Camilo1408/config-ricevi/demo_tolva/repeticion/IMG_1577_0011.jpg

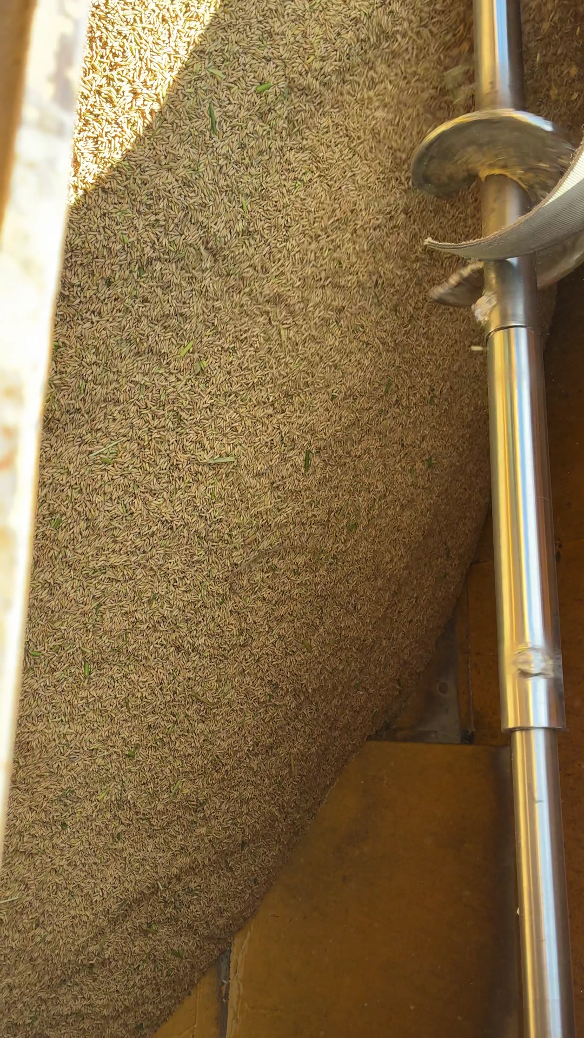
demo_tolva/repeticion/IMG_1577_0011.jpg
