Camilo1408/config-ricevi/demo_tolva/repeticion/IMG_1577_0022.jpg

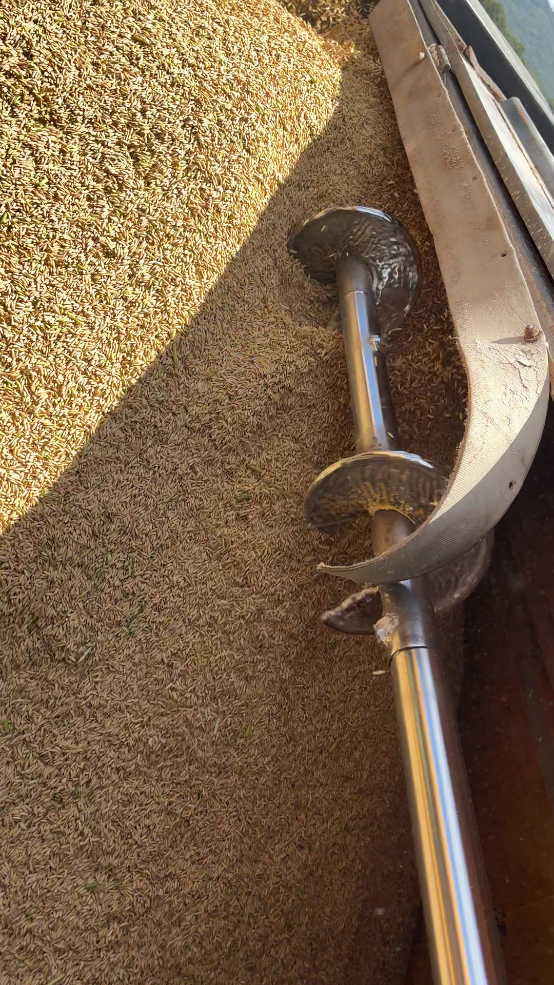
demo_tolva/repeticion/IMG_1577_0022.jpg
