Camilo1408/config-ricevi/demo_tolva/repeticion/IMG_1577_0026.jpg

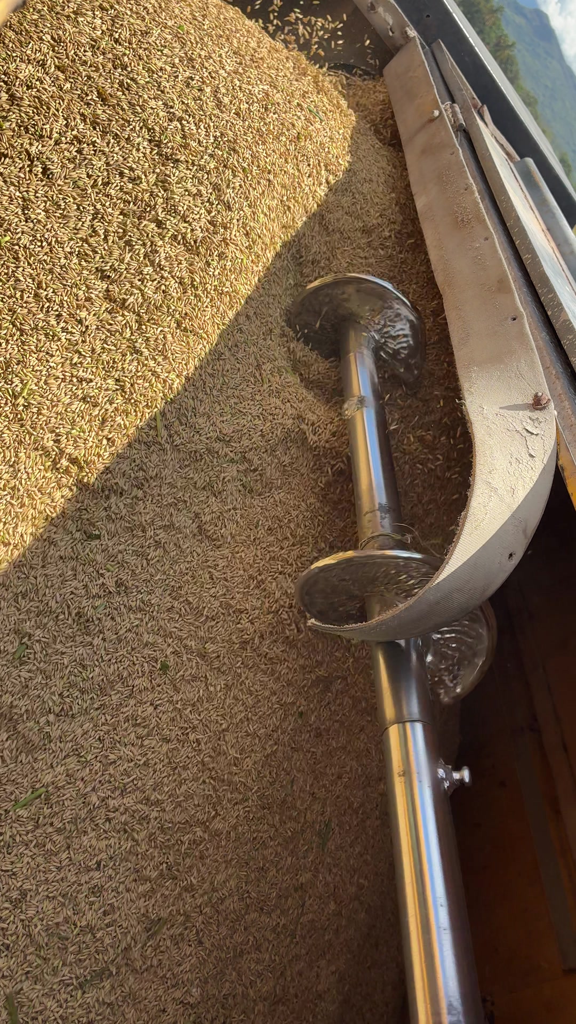
demo_tolva/repeticion/IMG_1577_0026.jpg
