Camilo1408/config-ricevi/demo_tolva/repeticion/IMG_1577_0034.jpg

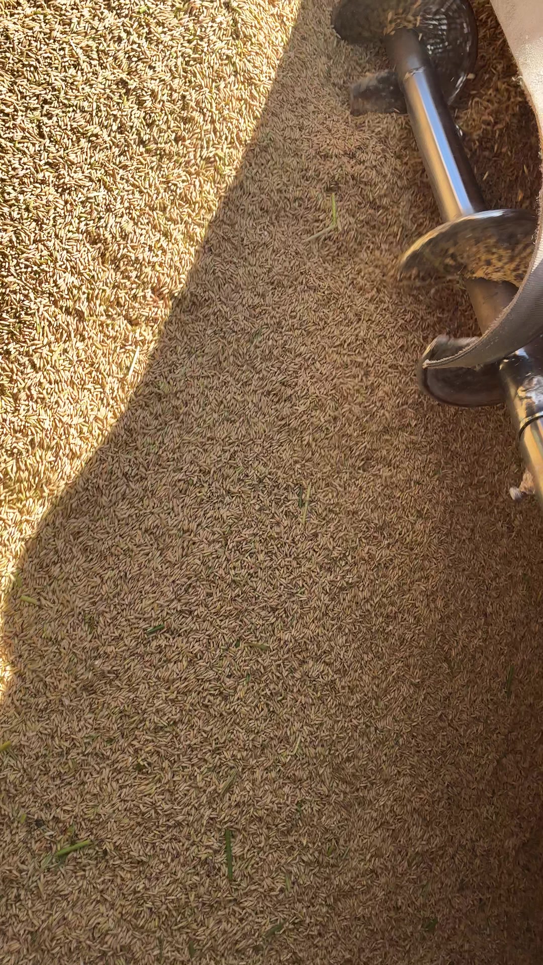
demo_tolva/repeticion/IMG_1577_0034.jpg
