Camilo1408/config-ricevi/(commit log)

2026-09-21 Sistema RiceVi en campo: configuracion, firmware, central y documentacion
    Configuracion completa para el montaje real sobre la cosechadora, en dos
    fases: captura de dataset primero, inferencia in situ despues, sobre el
    mismo codigo y sin recablear nada.
    config/ censo de los 8 nodos, calibraciones y planes. Fuente unica
    de verdad: las IP, ranuras de reloj, ROI y ritmos de captura
    salen de aqui, no del firmware.
    central/ FastAPI sobre la Raspberry Pi 5: ingesta, sincronizacion de
    reloj, turnos de subida, fusion, SQLite en WAL y HMI.
    nodos/ firmware de las 8 ESP32-S3 (4 camara, 2 Hall, 2 ultrasonico)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
2026-10-22 Hardware de octubre: nodos ESP32-C6, RCWL-1655, pilas AA y documentacion v1.2
    - Nodos de sensor en ESP32-C6 DevKitC (pines condicionales, LED en GPIO8).
    - Ultrasonico reescrito para el RCWL-1655 en modo Trig/Echo.
    - Hall: derivada sobre ventana deslizante de 1 s.
    - Nodos sin microSD; alimentacion con 4 AA Ni-MH en el censo.
    - Router Tenda N301, provision y HMI actualizados.
    - docs/01 v1.2, README y nodos/README con el hardware actual.
2026-10-22 Documentacion v1.2 completa: docs/02, docs/03, diagramas y entregables
    - docs/02 y docs/03 pasan a v1.2 (partiendo de la v1.1): compilacion para
    ESP32-C6, pilas AA Ni-MH, nodos sin microSD, LiFePO4 de cabina, Tenda N301.
    - Diagramas 01, 02 y 05 redibujados con el hardware actual.
    - docx y pdf de los tres capitulos regenerados.
    - Textos de checksum/timeout en censo y contratos acordes al RCWL-1655.
2026-10-23 Velocidad por GPS, siete nodos y documentacion v1.3 con el concurso
    La velocidad de avance pasa del Hall de rueda (NH02) a un GPS USB VK-162
    (u-blox 7) conectado a la Pi, con la antena en el techo de la cabina.
    - central/app/gps.py: lee NMEA (RMC/GGA) por /dev/serial/by-id, guarda
    ground_speed, la filtrada (3 s, reposo < 0,2 m/s), satelites y hdop
    como telemetria RPI01/GPS01. La posicion se descarta.
    - Censo 1.1.0: sale NH02, quedan siete nodos y siete ranuras; nuevos
    codigos sin_fix, hdop_alto y reposo.
    - Fusion: reel index con la velocidad del GPS y la muestra de rpm mas
    cercana; estado_maquina pasa a ground_speed_* con migracion de bases
    viejas. HMI con fila GPS. Exportacion co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
2026-10-23 Quita del repositorio lo del concurso
    El repositorio es solo del sistema: hardware, firmware, configuracion,
    documentacion tecnica, guias e historial. Sale docs/concurso/ y las
    menciones al concurso en el 00, el README y el censo. Entregables
    regenerados.
2026-10-23 Quita las referencias al banco de pruebas
    El repositorio describe solo el sistema de campo y sus avances. Salen las
    menciones a prubea-conex del README, el 00, modelos/ y el firmware comun.
    generar_documentos.ps1 deja de usar el entorno del banco: usa su propio
    .venv-docs (no versionado) o RICEVI_PY_DOCS. Entregables regenerados.
2026-10-24 Sesion nueva en cada arranque y primera prueba del GPS
    Sin camaras no se creaba la carpeta de frames de la sesion y cada
    reinicio de la central repetia el session_id (R007) con el reloj de
    sesion en cero: corridas mezcladas, el HMI mostrando el molinete de
    otra corrida con edad negativa y el GPS de la segunda corrida chocando
    con el UNIQUE de telemetria.
    - main.py: el numero de sesion sigue al mayor entre las carpetas de
    frames y la tabla sesiones (basedatos.sesiones_registradas).
    - prueba_humo.py: dos reinicios sin frames no repiten la sesion (52/52;
    con el main.py anterior falla R002 -> R002).
    - ricevi-central.service: StartLimitIntervalSec pasa a [Unit]; en
    [Service] systemd lo ign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
2026-10-29 Demo del modelo de tolva en el puerto 8001, aparte de la captura
    Servicio propio (ricevi-ia-demo) con su entorno, Nice=10 y sin escritura en
    disco. La central no cambia y sigue en RICEVI_MODELO=ninguno. Los pesos se
    copian aparte, como los de modelos/pesos.
